lokapin-indonesia/Hardware_3172/3Dmodel/k2-1808sn-a4sw-miniature-tactile-switch-1.snapshot.3/datasheet_K2-1808SN.png

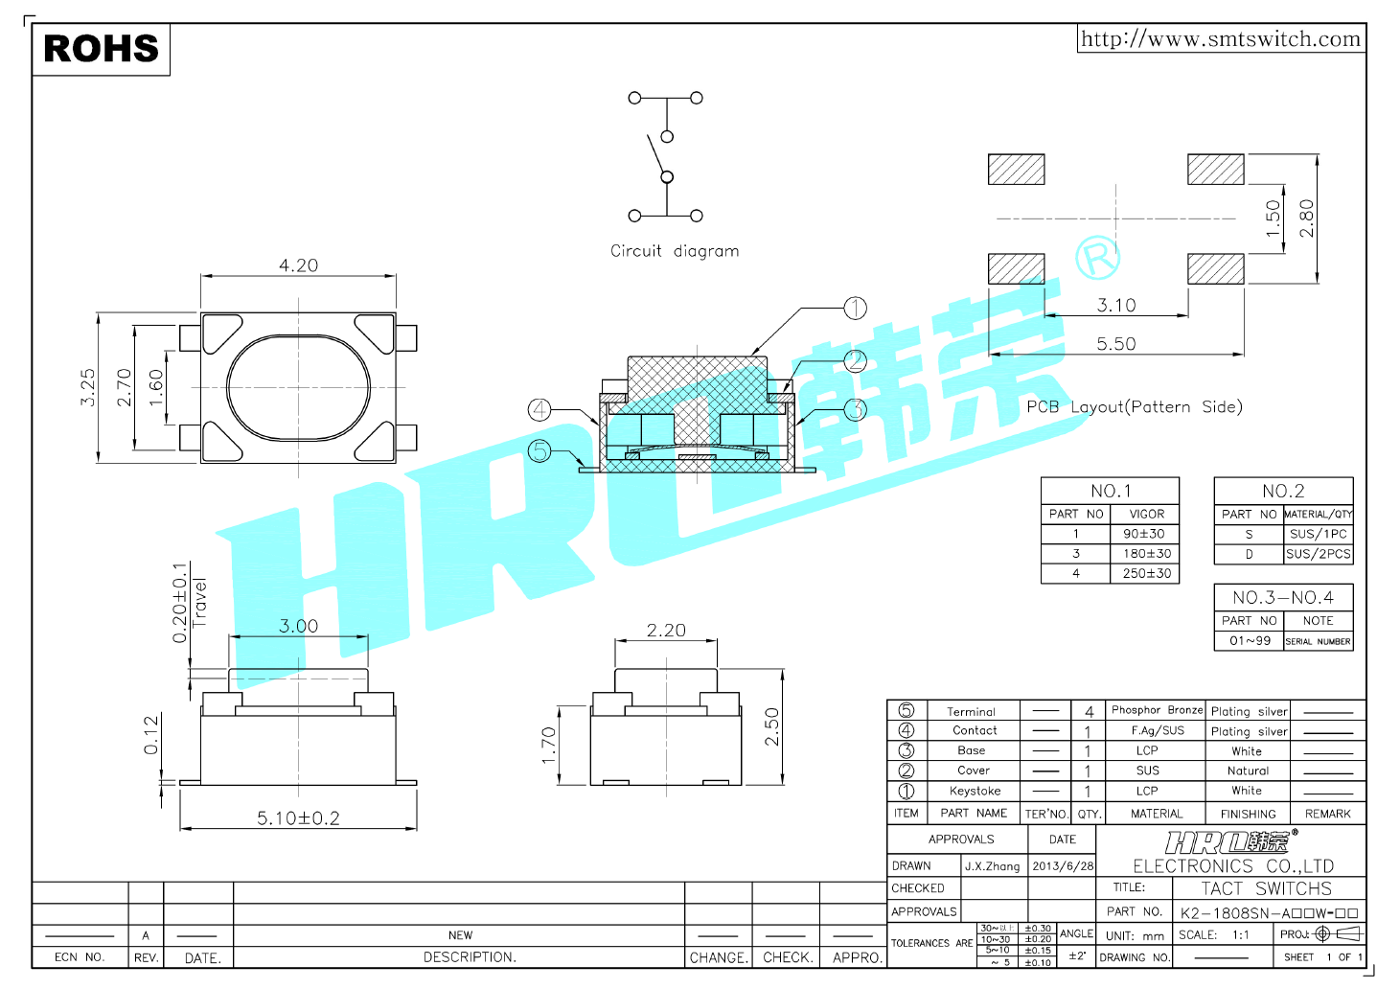
3Dmodel/k2-1808sn-a4sw-miniature-tactile-switch-1.snapshot.3/datasheet_K2-1808SN.png
