lokapin-indonesia/Hardware_3172/3Dmodel/crystal-smd-seikoepson-mc146-4pin-6-7x1-5mm-1.snapshot.10/Crystal_SMD_SeikoEpson_MC146-4Pin_6.7x1.5mm.step

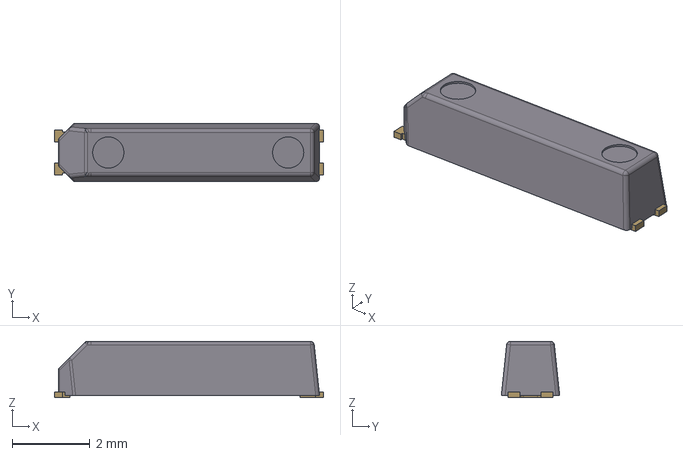
[picture p2: CAD file, 2022-10-07]
3Dmodel/crystal-smd-seikoepson-mc146-4pin-6-7x1-5mm-1.snapshot.10/Crystal_SMD_SeikoEpson_MC146-4Pin_6.7x1.5mm.step
6.90 x 1.50 x 1.45 mm
