lokapin-indonesia/Hardware_3172/3Dmodel/k2-1808sn-a4sw-miniature-tactile-switch-1.snapshot.3/tact_switch_K2-1808SN-A4SW.STEP

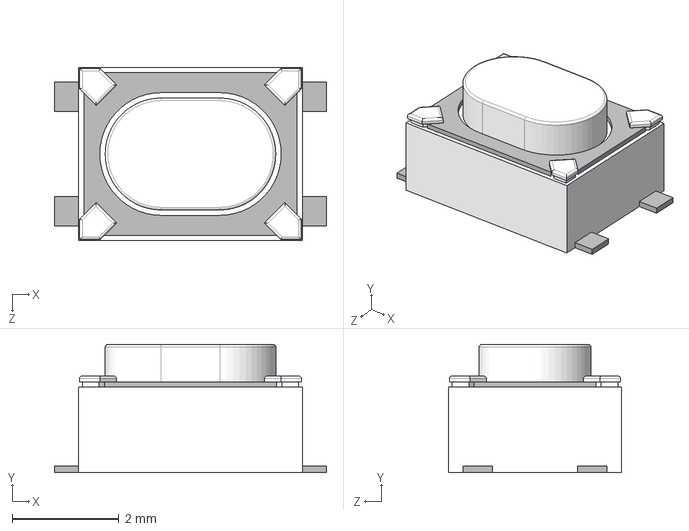
[picture p3: CAD file, 2022-10-07]
3Dmodel/k2-1808sn-a4sw-miniature-tactile-switch-1.snapshot.3/tact_switch_K2-1808SN-A4SW.STEP
5.10 x 2.40 x 3.25 mm
