lokapin-indonesia/Hardware_3172/3Dmodel/LGA-14.STEP

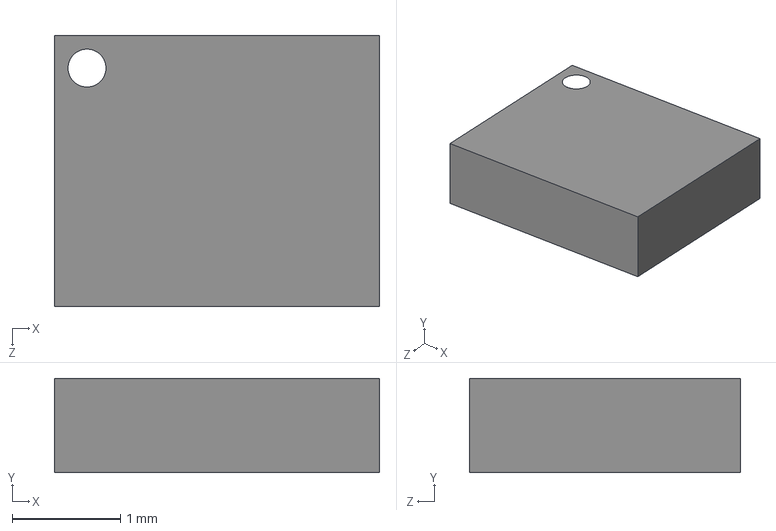
[picture p4: CAD file, 2022-10-07]
3Dmodel/LGA-14.STEP
3.00 x 0.87 x 2.50 mm
