lokapin-indonesia/Hardware_3172/3Dmodel/lora-ra-02-ai-thinker-module-1.snapshot.2/LoRa_Module_RA-02_AiThinker.step

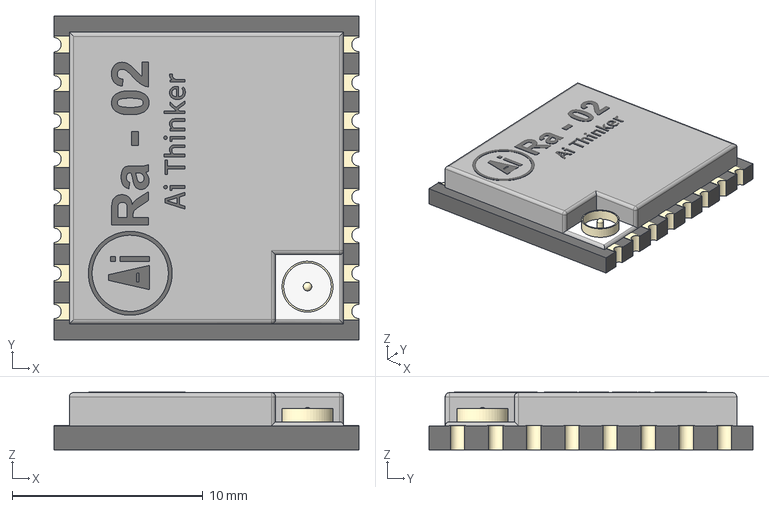
[picture p5: CAD file, 2022-10-07]
3Dmodel/lora-ra-02-ai-thinker-module-1.snapshot.2/LoRa_Module_RA-02_AiThinker.step
16.0 x 17.0 x 3.03 mm
