lokapin-indonesia/Hardware_3172/LokapinLib/LSM6DS3.step

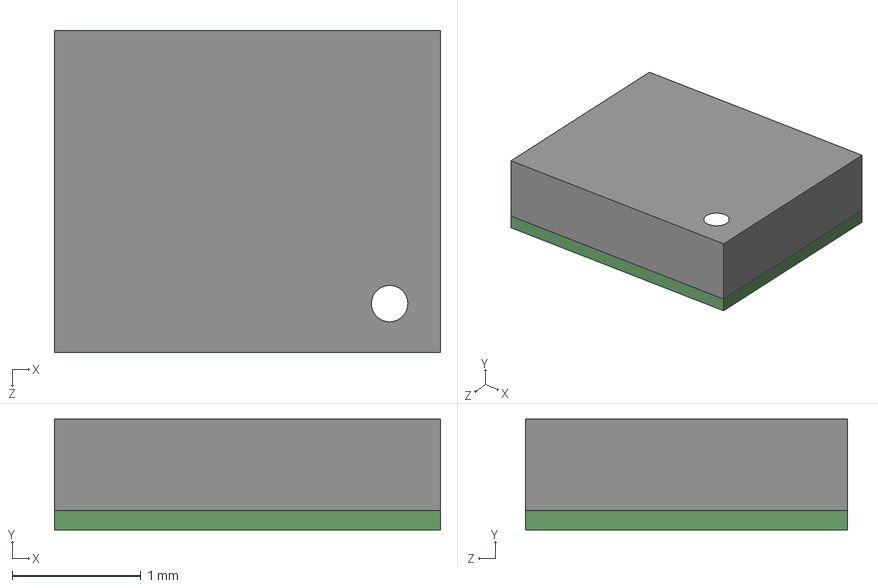
[picture p6: CAD file, 2022-09-25]
LokapinLib/LSM6DS3.step
3.00 x 0.86 x 2.50 mm
