lokapin-indonesia/Hardware_3172/3Dmodel/LGA-12_KXTJ3-1057--3DModel-STEP-56544.STEP

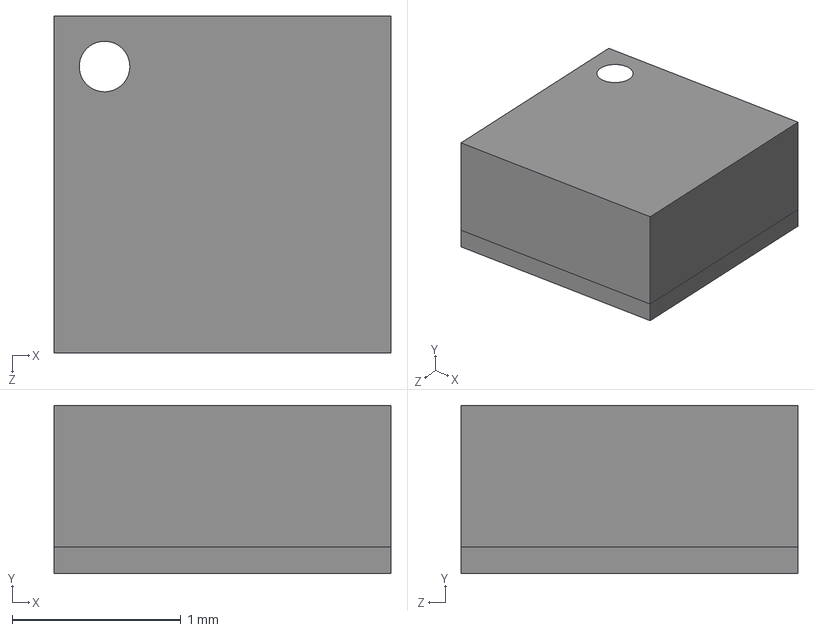
[picture p7: CAD file, 2022-10-07]
3Dmodel/LGA-12_KXTJ3-1057--3DModel-STEP-56544.STEP
2.00 x 1.00 x 2.00 mm
