lokapin-indonesia/Hardware_3172/3Dmodel/qfn12x12.step

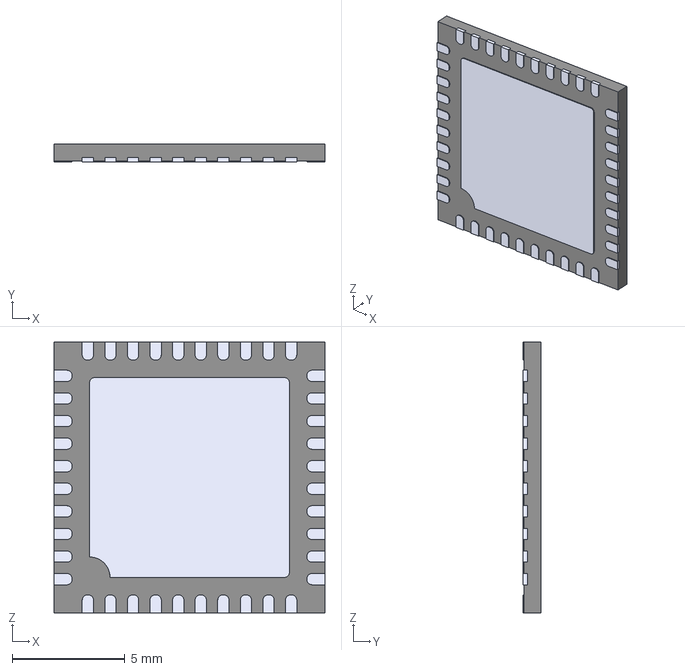
[picture p8: CAD file, 2022-10-07]
3Dmodel/qfn12x12.step
12.0 x 0.8 x 12.0 mm
