lokapin-indonesia/Hardware_3172/3Dmodel/JST_1.25_2pos.STEP

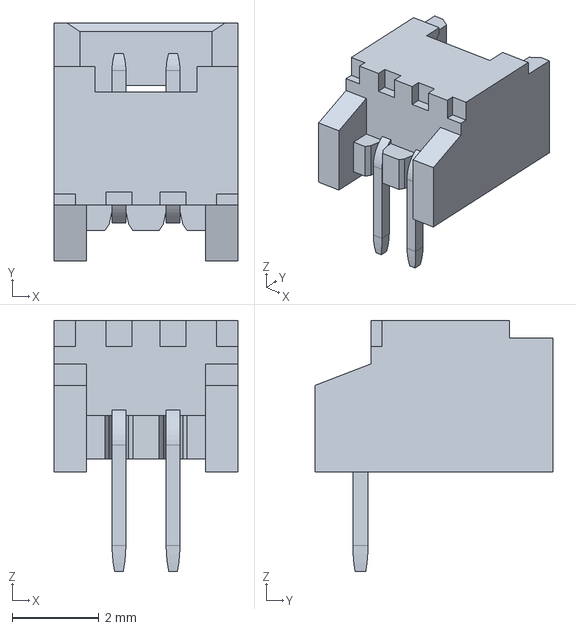
[picture p9: CAD file, 2022-10-07]
3Dmodel/JST_1.25_2pos.STEP
4.25 x 5.50 x 5.80 mm
