lokapin-indonesia/Hardware_3172/3Dmodel/L80RE-M37.step

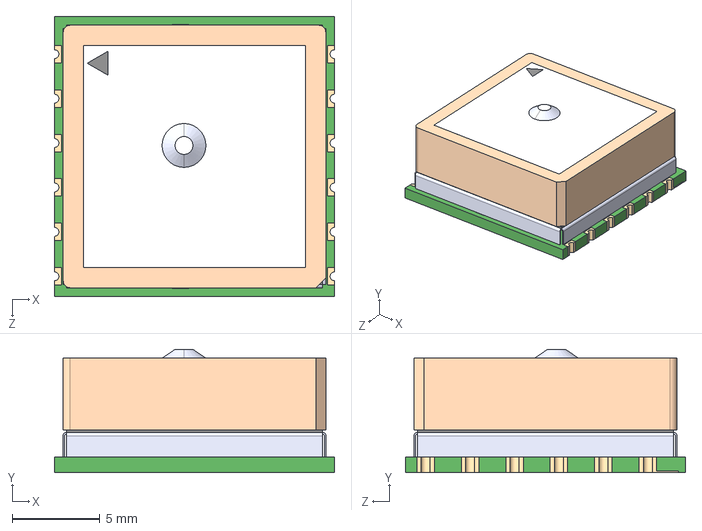
[picture p10: CAD file, 2022-10-07]
3Dmodel/L80RE-M37.step
16.0 x 7.05 x 16.0 mm
