lokapin-indonesia/Hardware_3172/3Dmodel/DFN_1x1_MIC5504-3.3YMT-T5.STEP

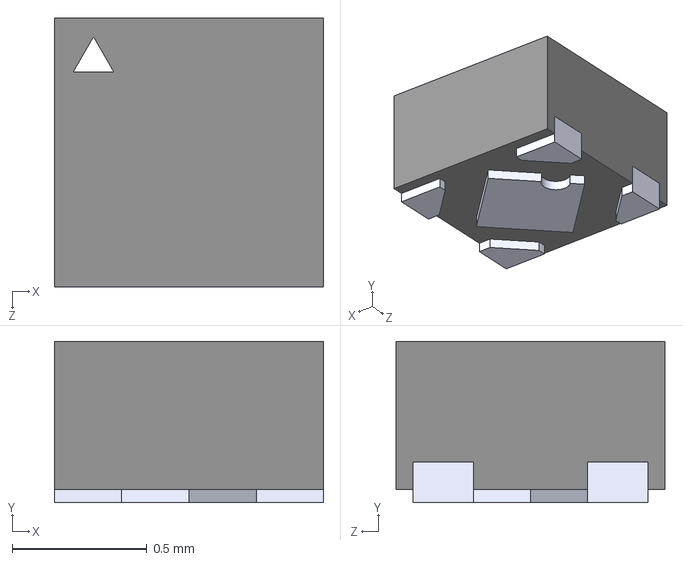
[picture p11: CAD file, 2022-10-07]
3Dmodel/DFN_1x1_MIC5504-3.3YMT-T5.STEP
1.00 x 0.6 x 1.00 mm
