lokapin-indonesia/Hardware_3172/3Dmodel/WLCSP-4.STEP

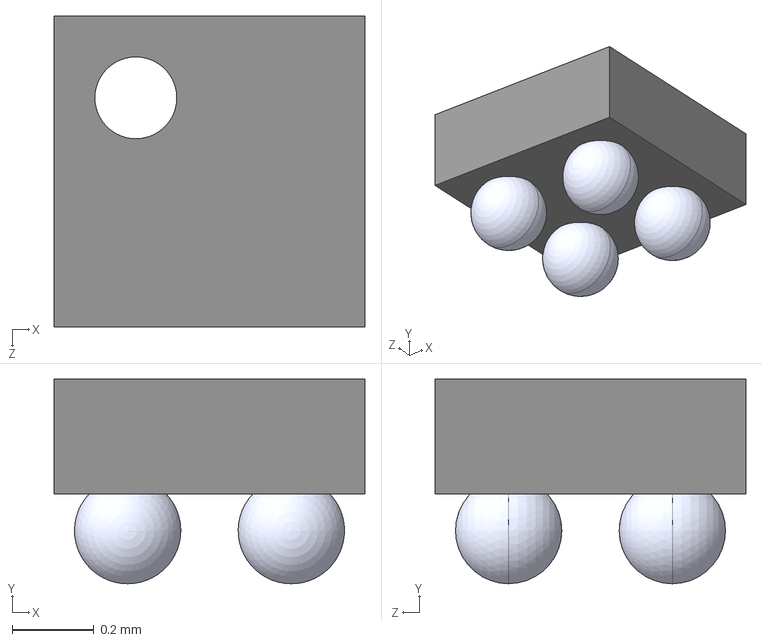
[picture p12: CAD file, 2022-09-25]
3Dmodel/WLCSP-4.STEP
0.76 x 0.5 x 0.76 mm
