lokapin-indonesia/Hardware_3172/3Dmodel/532610271.stp

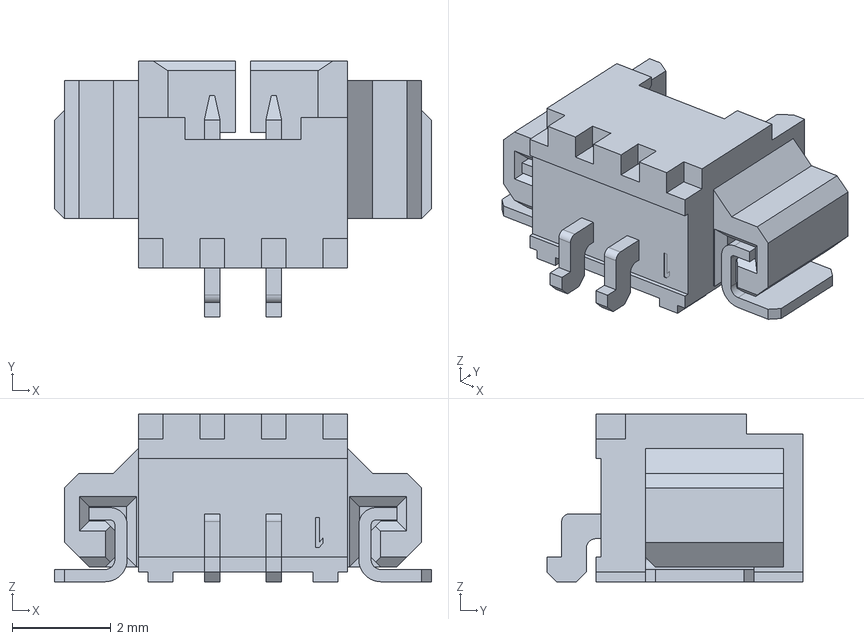
[picture p13: CAD file, 2022-10-07]
3Dmodel/532610271.stp
7.65 x 5.20 x 3.40 mm
