lokapin-indonesia/Hardware_3172/(list of files, cad)

Other CAD files:
3Dmodel/LoRa_Module_RA-02_AiThinker.f3d
3Dmodel/k2-1808sn-a4sw-miniature-tactile-switch-1.snapshot.3/tact_switch_K2-1808SN-A4SW.SLDPRT
3Dmodel/lora-ra-02-ai-thinker-module-1.snapshot.2/LoRa_Module_RA-02_AiThinker.f3d
