lokapin-indonesia/Hardware_3172/rak3172.kicad_pcb

## KiCad design rak3172.kicad_pcb (2022-12-10)

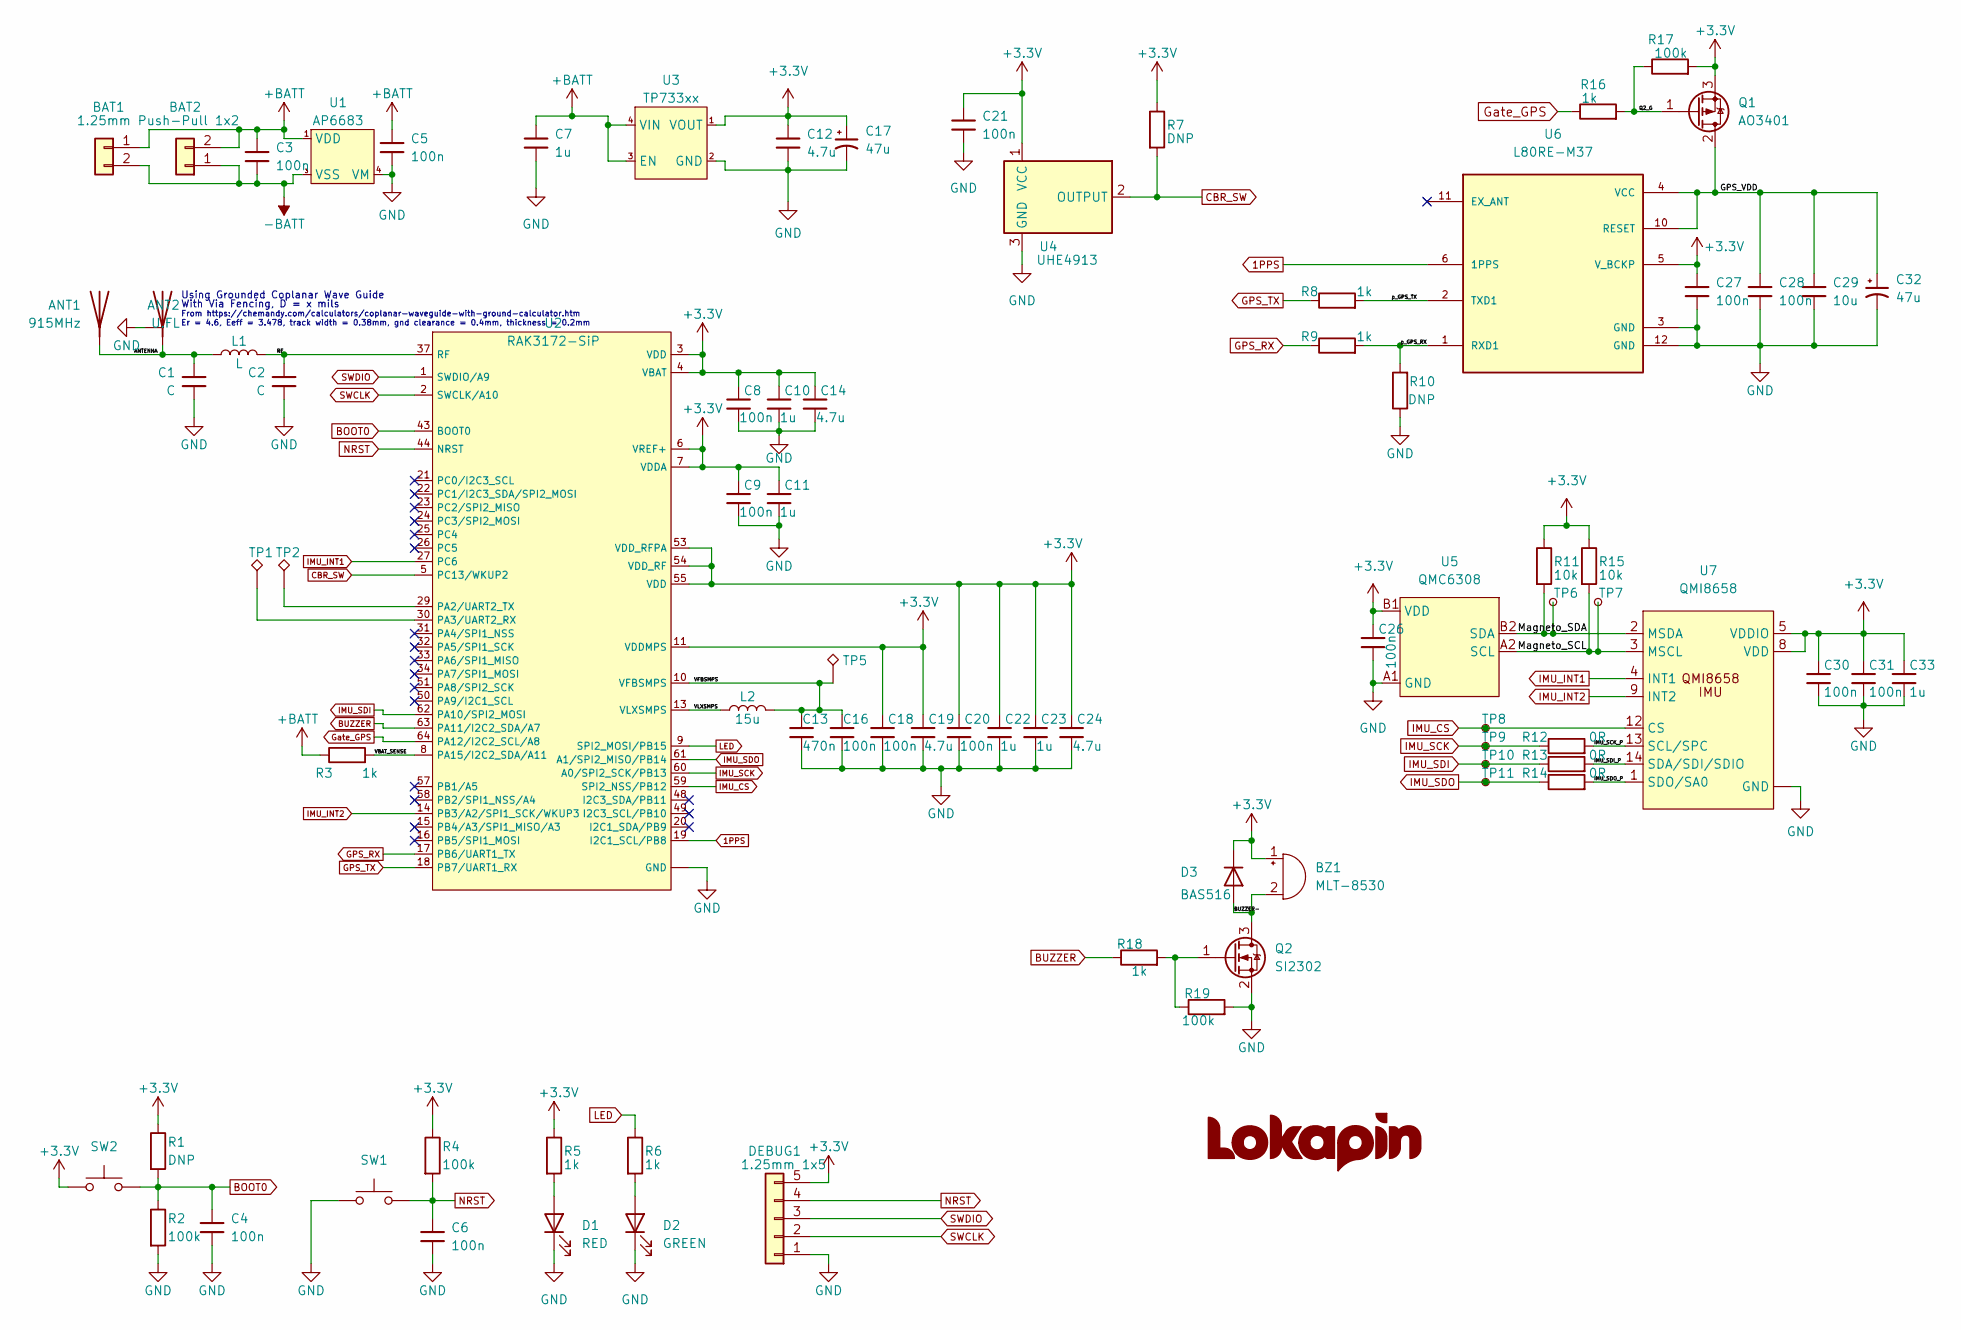
[picture p14: schematic rak3172.kicad_sch]

Parts:
ANT1: 915MHz; TestPoint_THTPad_D2.0mm_Drill1.0mm
ANT2: U.FL; U.FL_Hirose_U.FL-R-SMT-1_Vertical
BAT1, BAT2: 1.25mm Push-Pull 1x2; 1.25-2PWB DEALON
BZ1: MLT-8530; MagneticBuzzer_8530_SMD
C1, C2: C; C_0402_1005Metric
C3, C4, C5, C6, C8, C9, C16, C18, C20, C21, C26, C27, C28, C30, C31: 100n; C_0402_1005Metric
C7, C10, C11, C22, C23, C33: 1u; C_0402_1005Metric
C12, C14, C19, C24: 4.7u; C_0402_1005Metric
C13: 470n; C_0402_1005Metric
C17, C32: 47u; CP_EIA-3216-18_Kemet-A
C29: 10u; C_0402_1005Metric
D1: RED; LED_0603_1608Metric
D2: GREEN; LED_0603_1608Metric
D3: BAS516; D_SOD-523
DEBUG1: 1.25mm 1x5; Hirose_DF13-05P-1.25DSA_1x05_P1.25mm_Vertical
L1: L; L_0402_1005Metric
L2: 15u; L_0805_2012Metric
Q1: AO3401; SOT-23
Q2: SI2302; SOT-23
R1, R7, R10: DNP; R_0402_1005Metric
R2, R4, R17, R19: 100k; R_0402_1005Metric
R3, R5, R6, R8, R9, R16, R18: 1k; R_0402_1005Metric
R11, R15: 10k; R_0402_1005Metric
R12, R13, R14: 0R; R_0402_1005Metric
SW1, SW2: SW_Push; 5.2mm x 3.35mm Tactile Switch
TP1, TP2, TP5: TestPoint_Alt; TestPoint_Pad_D1.0mm
TP6, TP7, TP8, TP9, TP10, TP11: TestPoint_Small; TestPoint_Pad_D1.0mm
U1: AP6683; OnSemi_XDFN4-1EP_1.0x1.0mm_EP0.52x0.52mm
U2: RAK3172-SiP
U3: TP733xx; OnSemi_XDFN4-1EP_1.0x1.0mm_EP0.52x0.52mm
U4: UHE4913; SOT-23
U5: QMC6308
U6: L80RE-M37; XCVR_L80RE-M37
U7: QMI8658

Connections:
1PPS: U2.19 (I2C1_SCL/PB8), U6.6 (1PPS)
+3V3: BZ1.1 (-), C8.1, C9.1, C10.1, C11.1, C12.1, C14.1, C17.1, C18.1, C19.1, C20.1, C21.1, C22.1, C23.1, C24.1, C26.1, C27.1, C30.1, C31.1, C33.1, D3.1 (K), DEBUG1.5, Q1.3 (S), R1.1, R4.1, R5.1, R7.1, R11.1, R15.1, R17.2, SW2.1, U2.3 (VDD), U2.4 (VBAT), U2.6 (VREF+), U2.7 (VDDA), U2.11 (VDDMPS), U2.53 (VDD_RFPA), U2.54 (VDD_RF), U2.55 (VDD), U3.1 (VOUT), U4.1 (VCC), U5.B1 (VDD), U6.5 (V_BCKP), U7.5 (VDDIO), U7.8 (VDD)
+BATT: BAT1.1, BAT2.2, C3.1, C5.1, C7.1, R3.1, U1.1 (VDD), U3.3 (EN), U3.4 (VIN)
-BATT: BAT1.2, BAT2.1, C3.2, U1.2 (VSS), U1.3 (VSS)
/ANTENNA: ANT1.1 (A), ANT2.1 (A), C1.1, L1.2
/BUZZER-: BZ1.2 (+), D3.2 (A), Q2.3 (D)
/GPS_VDD: C28.1, C29.1, C32.1, Q1.2 (D), U6.4 (VCC), U6.10 (RESET)
/IMU_SCK_P: R12.2, U7.13 (SCL/SPC)
/IMU_SDI_P: R13.2, U7.14 (SDA/SDI/SDIO)
/IMU_SDO_P: R14.2, U7.1 (SDO/SA0)
/Magneto_SCL: R15.2, TP7.1, U5.A2 (SCL), U7.3 (MSCL)
/Magneto_SDA: R11.2, TP6.1, U5.B2 (SDA), U7.2 (MSDA)
/Q2_G: Q1.1 (G), R16.2, R17.1
/RF: C2.1, L1.1, U2.37 (RF)
/VBAT_SENSE: R3.2, U2.8 (PA15/I2C2_SDA/A11)
/VFBSMPS: C13.1, C16.1, L2.2, TP5.1, U2.10 (VFBSMPS)
/VLXSMPS: L2.1, U2.13 (VLXSMPS)
/p_GPS_RX: R9.2, R10.2, U6.1 (RXD1)
/p_GPS_TX: R8.2, U6.2 (TXD1)
BOOT0: C4.1, R1.2, R2.1, SW2.3, U2.43 (BOOT0)
BUZZER: R18.1, U2.63 (PA11/I2C2_SDA/A7)
CBR_SW: R7.2, U2.5 (PC13/WKUP2), U4.2 (OUTPUT)
GND: ANT2.2 (GND), C1.2, C2.2, C4.2, C5.2, C6.2, C7.2, C8.2, C9.2, C10.2, C11.2, C12.2, C13.2, C14.2, C16.2, C17.2, C18.2, C19.2, C20.2, C21.2, C22.2, C23.2, C24.2, C26.2, C27.2, C28.2, C29.2, C30.2, C31.2, C32.2, C33.2, D1.1 (K), D2.1 (K), DEBUG1.1, Q2.2 (S), R2.2, R10.1, R19.2, SW1.1, U1.4 (VM), U2.12 (GND), U2.28 (GND), U2.35 (GND), U2.36 (GND), U2.38 (GND), U2.39 (GND), U2.46 (GND), U2.47 (GND), U2.52 (GND), U2.56 (GND), U2.65 (GND), U2.66 (GND), U2.67 (GND), U2.68 (GND), U2.69 (GND), U2.70 (GND), U2.71 (GND), U2.72 (GND), U2.73 (GND), U3.2 (GND), U4.3 (GND), U5.A1 (GND), U6.3 (GND), U6.12 (GND), U7.6 (GND), U7.7 (GND)
GPS_RX: R9.1, U2.17 (PB6/UART1_TX)
GPS_TX: R8.1, U2.18 (PB7/UART1_RX)
Gate_GPS: R16.1, U2.64 (PA12/I2C2_SCL/A8)
IMU_CS: TP8.1, U2.59 (SPI2_NSS/PB12), U7.12 (CS)
IMU_INT1: U2.27 (PC6), U7.4 (INT1)
IMU_INT2: U2.14 (PB3/A2/SPI1_SCK/WKUP3), U7.9 (INT2)
IMU_SCK: R12.1, TP9.1, U2.60 (A0/SPI2_SCK/PB13)
IMU_SDI: R13.1, TP10.1, U2.62 (PA10/SPI2_MOSI)
IMU_SDO: R14.1, TP11.1, U2.61 (A1/SPI2_MISO/PB14)
LED: R6.1, U2.9 (SPI2_MOSI/PB15)
NRST: C6.1, DEBUG1.4, R4.2, SW1.3, U2.44 (NRST)
unnamed: D1.2 (A), R5.2
unnamed: D2.2 (A), R6.2
unnamed: Q2.1 (G), R18.2, R19.1
unnamed: TP1.1, U2.30 (PA3/UART2_RX)
unnamed: TP2.1, U2.29 (PA2/UART2_TX)
SWCLK: DEBUG1.2, U2.2 (SWCLK/A10)
SWDIO: DEBUG1.3, U2.1 (SWDIO/A9)

Notes on the sheet:
From https://chemandy.com/calculators/coplanar-waveguide-with-ground-calculator.htm Er = 4.6, Eeff = 3.478, track width = 0.38mm, gnd clearance = 0.4mm, thickness = 0.2mm
Using Grounded Coplanar Wave Guide
With Via Fencing, D = x mils

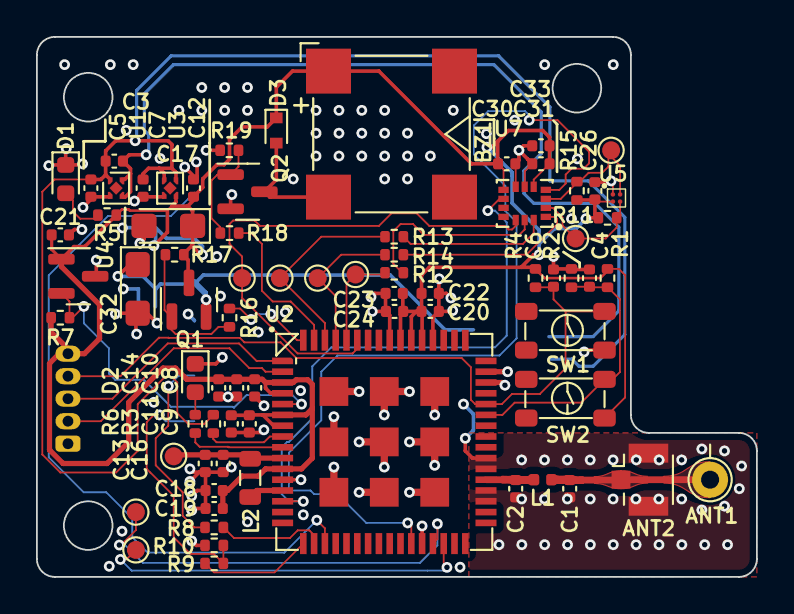
[picture p15: board rak3172.kicad_pcb from above]

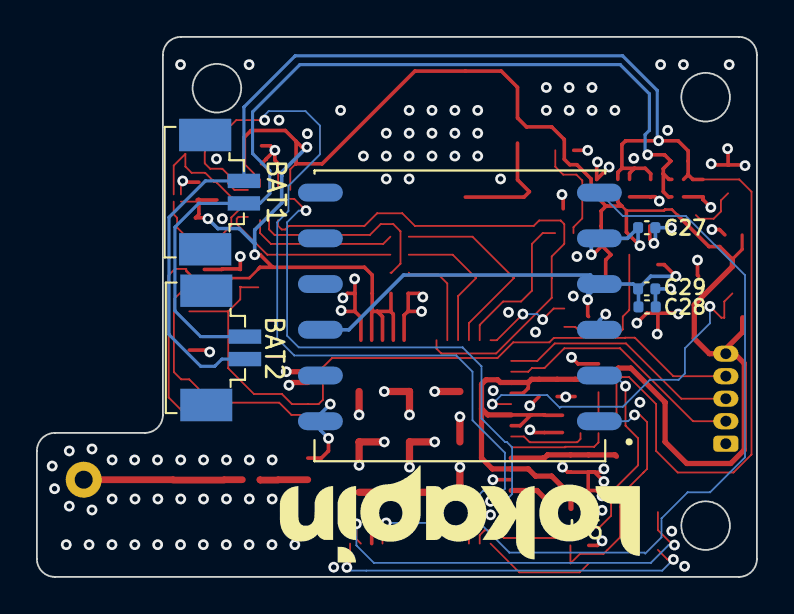
[picture p16: board rak3172.kicad_pcb from below]

Board: 4 copper layers, 40.0 x 30.0 mm, 81 parts (6 on the bottom side), 41 nets.
