lokapin-indonesia/Hardware_3172/(commit log)

2022-09-23 added rak3172 lib
    [rak3172.kicad_sch]
2022-09-25 routing done, untidy
    [28P,315.STEP, LSM6DS3--3DModel-STEP-56544.STEP, LSM6DS3.step, QST-qmi8610.kicad_pcb, QST-qmi8610.kicad_sch, rak3172.kicad_pcb, rak3172.kicad_sch]
2022-10-01 Q, ANT, D name deleted
    [rak3172.kicad_pcb]
2022-10-06 Added 3D Models (-Antenna) Added Manufacturing File (BOM/POS/Gerber) Tidied up silkscreen placement Added via stitching Added via fencing for GCPW Changed bat connector position and package (to SMD)
    [532610271.stp, BOM-rak3172.csv, Crystal_SMD_SeikoEpson_MC146-4Pin_6.7x1.5mm.step, DFN_1x1_MIC5504-3.3YMT-T5.STEP, L80RE-M37.step, LGA-12_KXTJ3-1057--3DModel-STEP-56544.STEP, LGA-14.STEP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]
